aradanmn/MSP430handheld-hardware/pcb/NETLIST.md

# Netlist (generated by pcb/gen_pcb.py -- do not edit)

| Net | Pins |
|-----|---|
| `+3V3` | A1.2, A4.4, C1.1, C13.1, C3.1, C4.1, C5.1, J3.2, R1.1, R10.1, R11.1, R12.1, R2.1, R3.1, R4.1, R5.1, R6.1, R7.1, R8.1, R9.1, U1.1, U2.16, U3.7, U3.8, U4.3, U4.7, U4.8 |
| `+5V` | A3.6, C10.1, C11.1, U5.6 |
| `AMP_BYP` | C8.1, U5.7 |
| `AMP_OUT` | C12.1, C9.1, U5.5 |
| `AUDIO_F` | C6.1, C7.1, R14.2 |
| `AUDIO_IN` | RV1.2, U5.3 |
| `AUDIO_PWM` | R14.1, U1.12 |
| `BTN_A` | R8.2, SW8.1, U2.6 |
| `BTN_B` | R7.2, SW7.1, U2.5 |
| `BTN_DOWN` | R2.2, SW2.1, U2.12 |
| `BTN_LEFT` | R3.2, SW3.1, U2.13 |
| `BTN_RIGHT` | R4.2, SW4.1, U2.14 |
| `BTN_SELECT` | R5.2, SW5.1, U2.3 |
| `BTN_START` | R6.2, SW6.1, U2.4 |
| `BTN_UP` | R1.2, SW1.1, U2.11 |
| `FLASH_CS` | R11.2, U1.19, U4.1 |
| `GND` | A1.1, A1.20, A2.4, A3.2, A3.5, A4.3, C1.2, C10.2, C11.2, C13.2, C14.2, C2.2, C3.2, C4.2, C5.2, C6.2, C8.2, D1.1, J1.2, J2.2, J3.1, R16.2, R19.2, RV1.1, SW1.2, SW2.2, SW3.2, SW4.2, SW5.2, SW6.2, SW7.2, SW8.2, SW9.1, U1.20, U2.10, U2.15, U2.8, U3.4, U4.4, U5.2, U5.4 |
| `LED1` | R17.1, U1.2 |
| `LED1_A` | D1.2, R17.2 |
| `MISO` | R13.2, U1.14, U3.2, U4.2 |
| `MOSI` | A1.8, U1.15, U3.5, U4.5 |
| `OLED_CS` | A1.15, R9.2, U1.8 |
| `OLED_DC` | A1.4, U1.9 |
| `OLED_RST` | A1.16, U1.10 |
| `PWR_EN` | A3.3, A4.1, SW9.2 |
| `RST` | C2.1, J3.5, R12.2, U1.16 |
| `RXD` | J3.3, U1.3 |
| `SCK` | A1.7, U1.7, U2.2, U3.6, U4.6 |
| `SPK+` | J2.1, R15.2 |
| `SPK_C` | C9.2, R15.1 |
| `SRAM_CS` | R10.2, U1.13, U3.1 |
| `SR_LOAD` | U1.11, U2.1 |
| `SR_QH` | R13.1, U2.9 |
| `TEST` | J3.6, U1.17 |
| `TXD` | J3.4, U1.4 |
| `VBAT` | A2.5, A3.1, A4.2, J1.1, R18.1 |
| `VBAT_SENSE` | C14.1, R18.2, R19.1, U1.6 |
| `VOL_HI` | C7.2, RV1.3 |
| `ZOBEL` | C12.2, R16.1 |

| Ref | Value | Side |
|-----|---|---|
| A1 | OLED 128x64 SSD1325 | front |
| A2 | USB-C LiPo charger | back |
| A3 | 5V boost | back |
| A4 | 3.3V buck-boost | front |
| C1 | 100nF | front |
| C2 | 1nF | front |
| C3 | 100nF | front |
| C4 | 100nF | front |
| C5 | 100nF | front |
| C6 | 100nF | front |
| C7 | 10uF | front |
| C8 | 10uF | front |
| C9 | 220uF | front |
| C10 | 100nF | front |
| C11 | 10uF | front |
| C12 | 47nF (opt) | front |
| C13 | 220uF (OLED kit) | front |
| C14 | 100nF | front |
| D1 | red 3mm | front |
| J1 | LiPo (JST-PH) | front |
| J2 | Speaker (solder wires) | back |
| J3 | PROG / UART | back |
| R1 | 10k | front |
| R2 | 10k | front |
| R3 | 10k | front |
| R4 | 10k | front |
| R5 | 10k | front |
| R6 | 10k | front |
| R7 | 10k | front |
| R8 | 10k | front |
| R9 | 10k | front |
| R10 | 10k | front |
| R11 | 10k | front |
| R12 | 47k | front |
| R13 | 1k | front |
| R14 | 1k | front |
| R15 | 10R | front |
| R16 | 10R (opt) | front |
| R17 | 1k | front |
| R18 | 470k | front |
| R19 | 470k | front |
| RV1 | 10k log (PTV09A) | front |
| SW1 | UP | front |
| SW2 | DOWN | front |
| SW3 | LEFT | front |
| SW4 | RIGHT | front |
| SW5 | SELECT | front |
| SW6 | START | front |
| SW7 | B | front |
| SW8 | A | front |
| SW9 | EG1218 power | back |
| U1 | MSP430G2553IN20 | front |
| U2 | SN74HC165N | front |
| U3 | 23LC1024-I/P | front |
| U4 | W25Q128 (Adafruit #5634) | front |
| U5 | LM386N-1 | front |
