aradanmn/MSP430handheld-hardware/enclosure/renders/back_shell.png

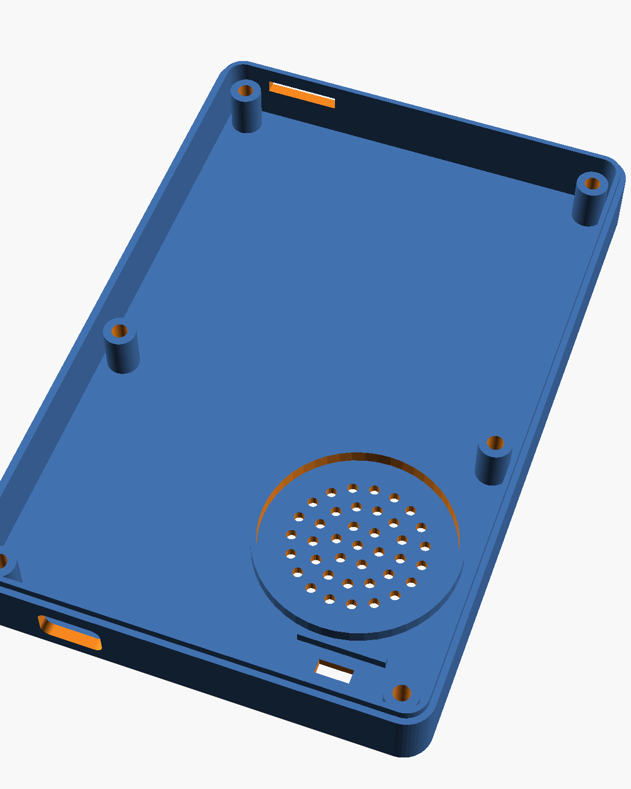
enclosure/renders/back_shell.png
