aradanmn/MSP430handheld-hardware/enclosure/renders/front_shell.png

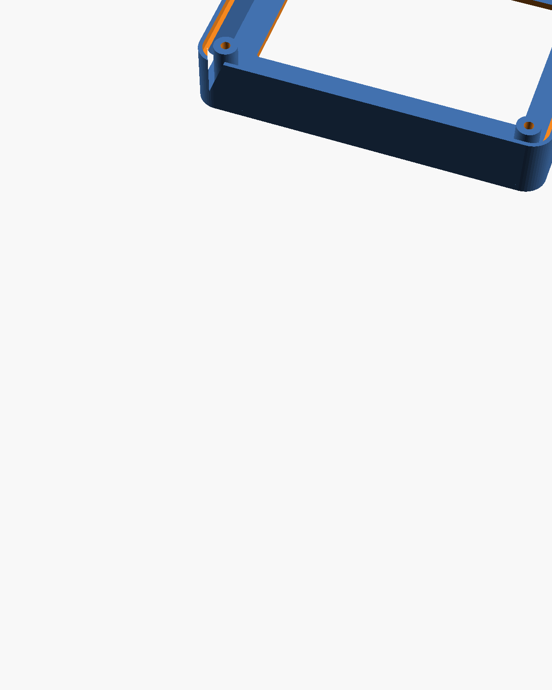
enclosure/renders/front_shell.png
