aradanmn/MSP430handheld-hardware/enclosure/renders/section_x21.png

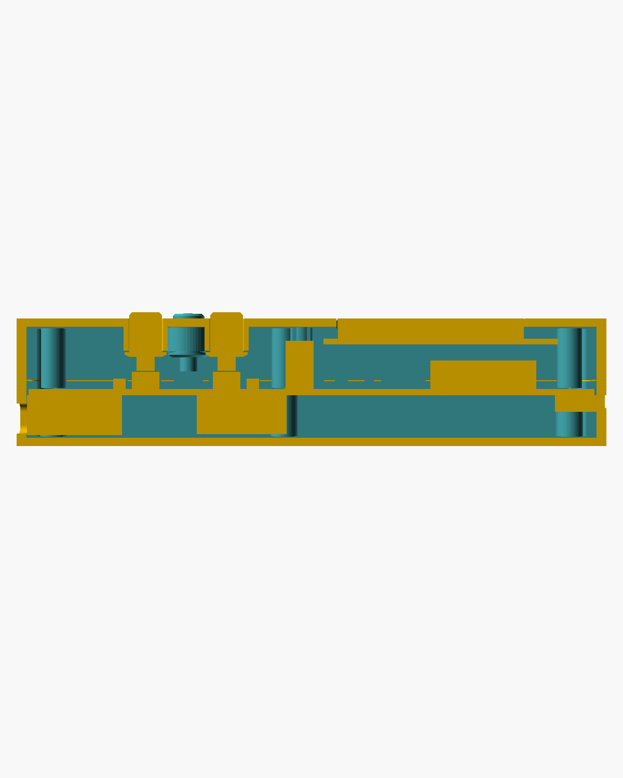
enclosure/renders/section_x21.png
