aradanmn/MSP430handheld-hardware/enclosure/renders/section_x45.png

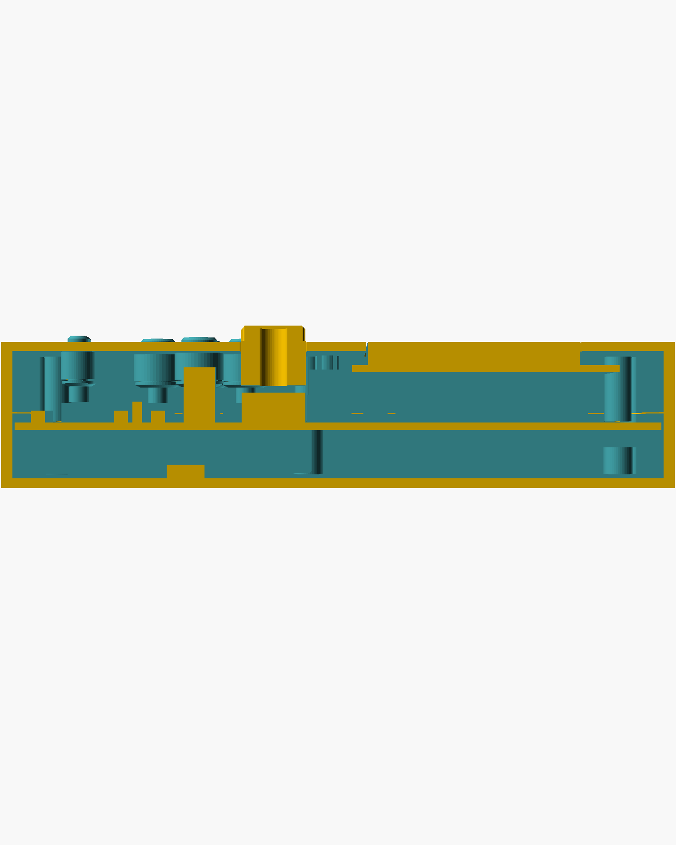
enclosure/renders/section_x45.png
