aradanmn/MSP430handheld-hardware/pcb/renders/bottom.png

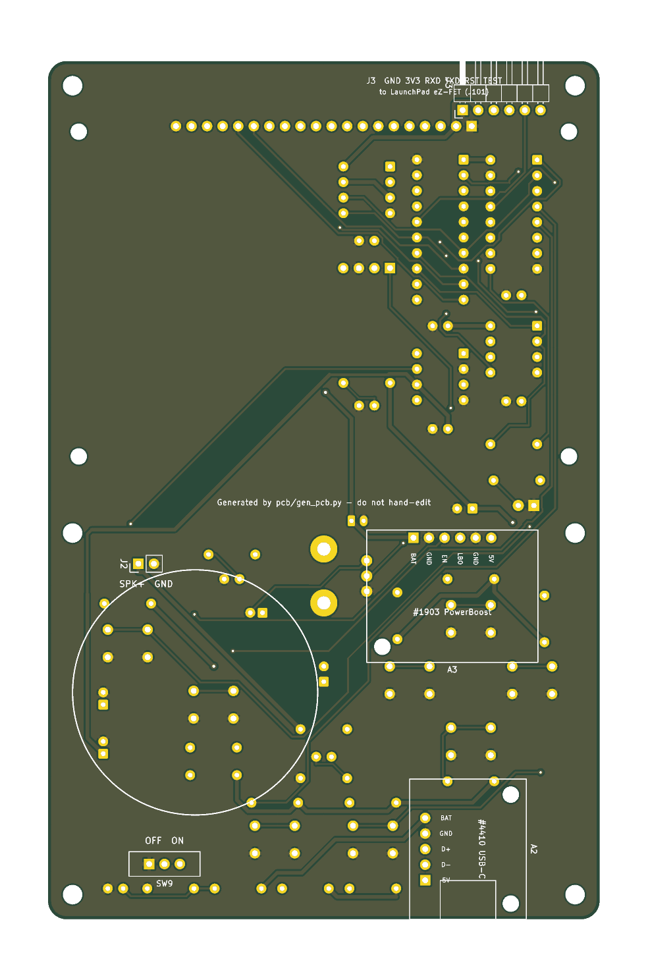
pcb/renders/bottom.png
