aradanmn/MSP430handheld-hardware/enclosure/stl/handheld_cap_dpad.stl

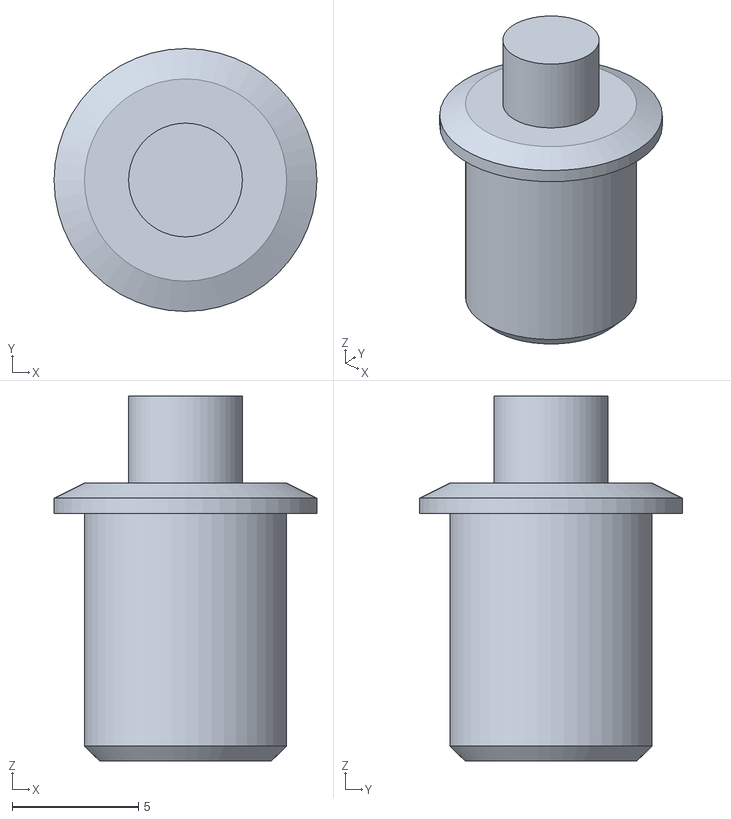
[picture p8: CAD file, 2026-11-09]
enclosure/stl/handheld_cap_dpad.stl
10.4 x 10.4 x 14.4
