aradanmn/MSP430handheld-hardware/pcb/fab/msp430_handheld-outline.dxf

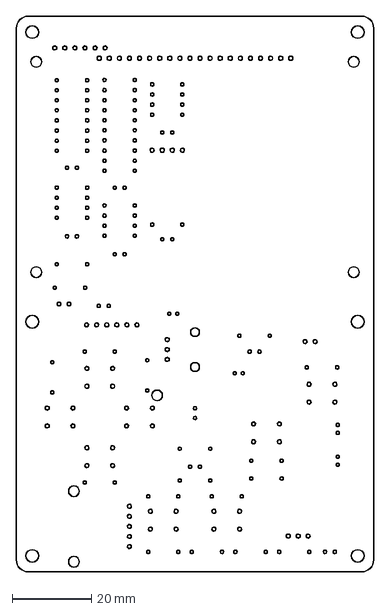
[picture p9: CAD file, 2026-11-09]
pcb/fab/msp430_handheld-outline.dxf
90.0 x 140.0 mm
