aradanmn/MSP430handheld-hardware/enclosure/stl/handheld_knob.stl

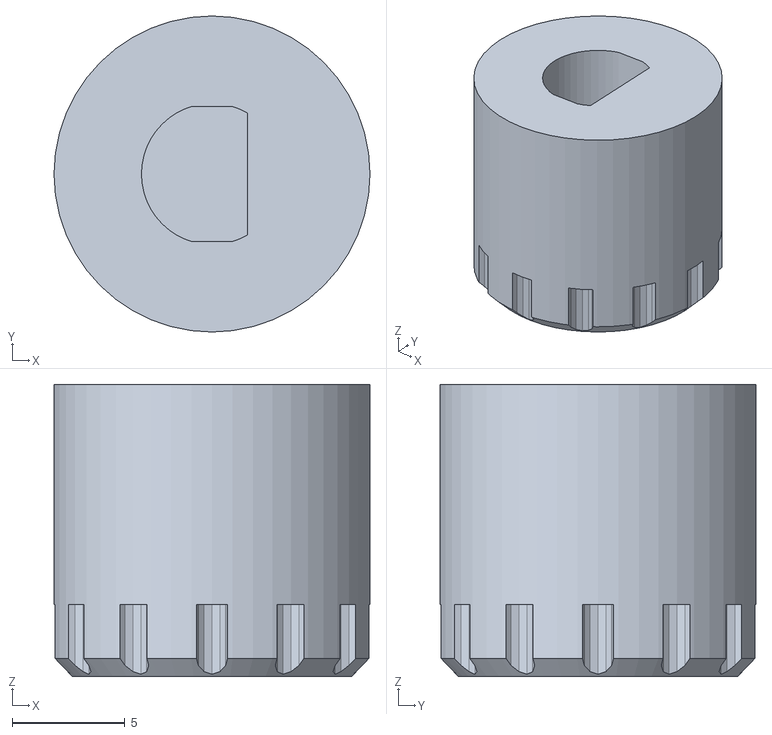
[picture p10: CAD file, 2026-11-09]
enclosure/stl/handheld_knob.stl
14.0 x 14.0 x 12.9
