aradanmn/MSP430handheld-hardware/pcb/fab/msp430_handheld.step

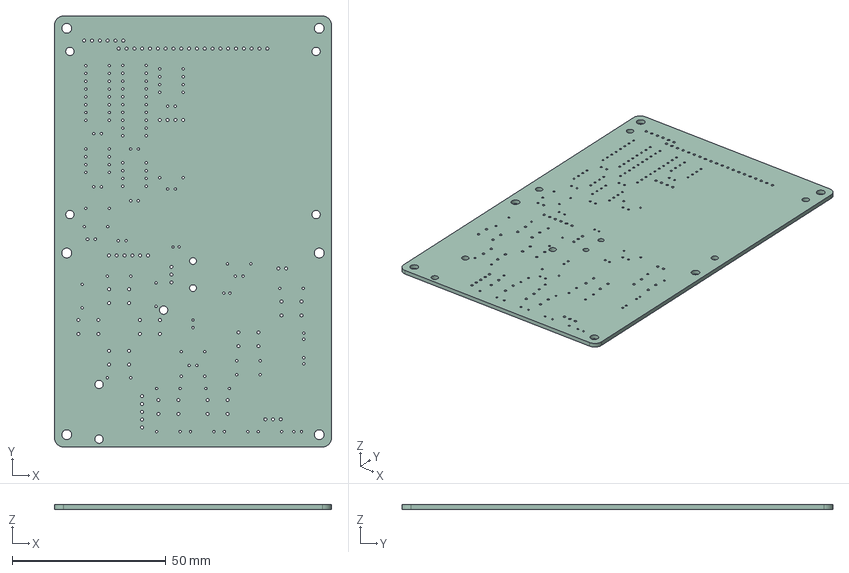
[picture p11: CAD file, 2026-11-09]
pcb/fab/msp430_handheld.step
90.0 x 140.0 x 1.51 mm
