aradanmn/MSP430handheld-hardware/enclosure/stl/handheld_slider.stl

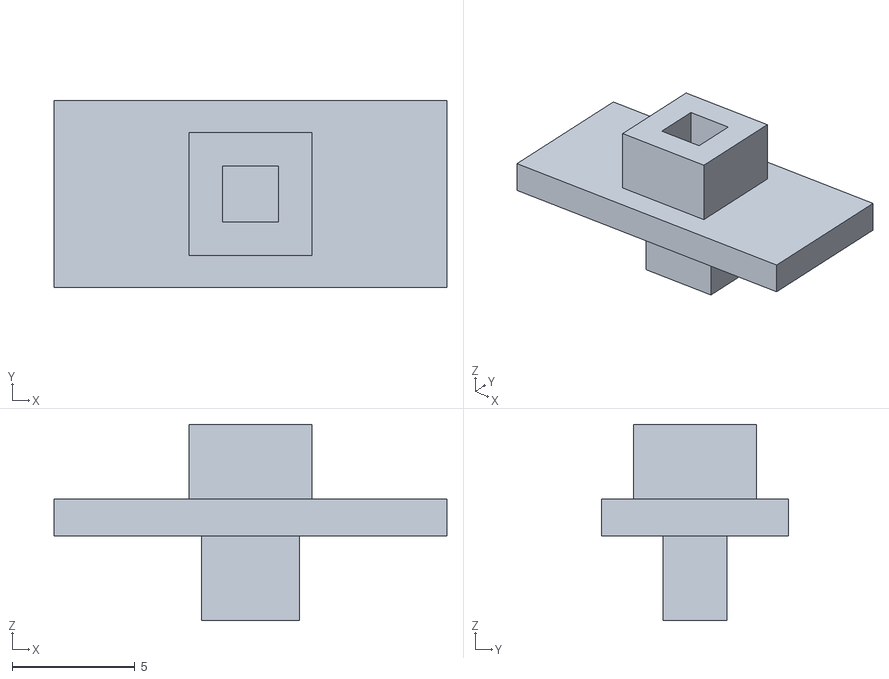
[picture p12: CAD file, 2026-11-09]
enclosure/stl/handheld_slider.stl
16.0 x 7.60 x 8.00
