aradanmn/MSP430handheld-hardware/enclosure/stl/handheld_cap_pill.stl

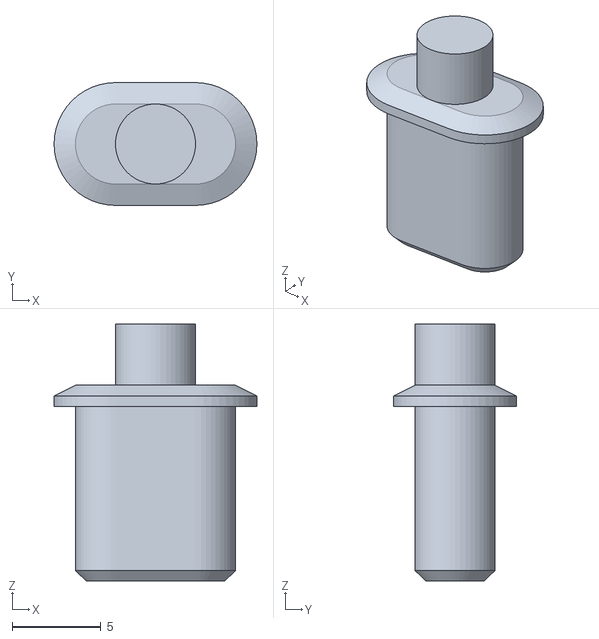
[picture p13: CAD file, 2026-11-09]
enclosure/stl/handheld_cap_pill.stl
11.4 x 6.90 x 14.4
