aradanmn/MSP430handheld-hardware/enclosure/stl/handheld_back.stl

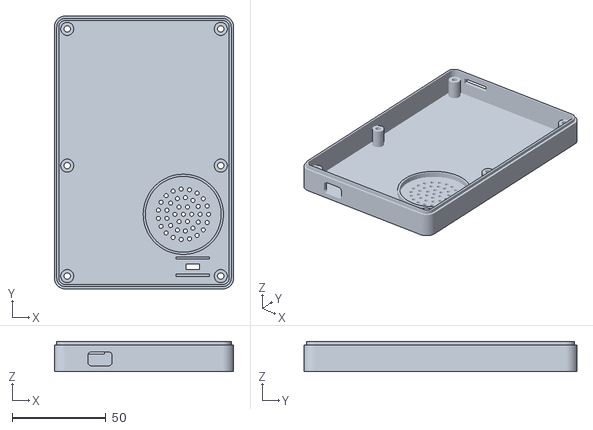
[picture p14: CAD file, 2026-11-09]
enclosure/stl/handheld_back.stl
95.8 x 145.8 x 16.1
