aradanmn/MSP430handheld-hardware/enclosure/stl/handheld_front.stl

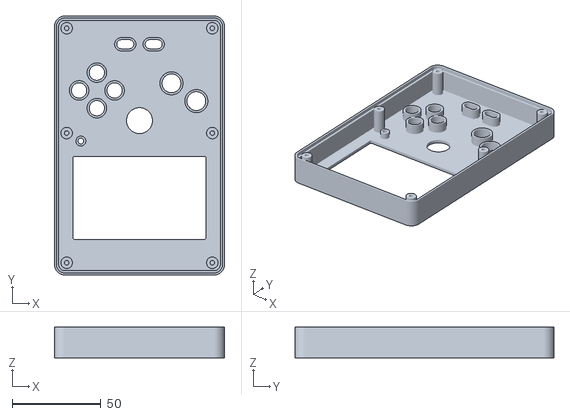
[picture p15: CAD file, 2026-11-09]
enclosure/stl/handheld_front.stl
95.8 x 145.8 x 17.4
