aradanmn/MSP430handheld-hardware/enclosure/stl/handheld_cap_ab.stl

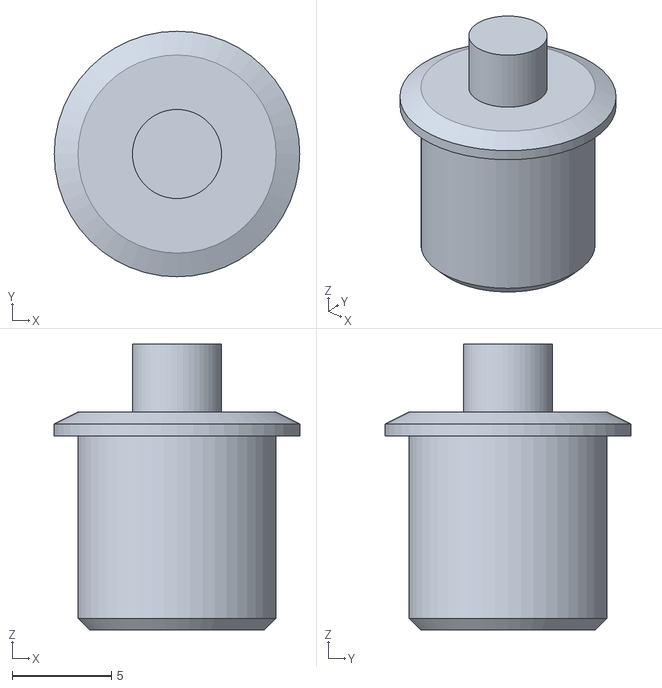
[picture p16: CAD file, 2026-11-09]
enclosure/stl/handheld_cap_ab.stl
12.4 x 12.4 x 14.4
