aradanmn/MSP430handheld-hardware/enclosure/board_params.scad

// GENERATED by pcb/gen_pcb.py from pcb/handheld_design.py -- do not edit.
// Board FRONT-view coordinates: origin top-left of the PCB, x right, y down, mm.
pcb_w = 90.0; pcb_h = 140.0; pcb_r = 3.0; pcb_t = 1.6;
case_screws = [[4, 4], [86, 4], [4, 77], [86, 77], [4, 136], [86, 136]];
oled_at = [2.5, 9.0]; oled_size = [85.0, 58.0]; oled_gap = 11.04;
oled_pcb_t = 1.4; oled_bezel = [5.5, 8.5, 74.0, 46.0]; oled_bezel_h = 5.0;
oled_holes = [[2.5, 2.5], [82.5, 2.5], [2.5, 55.5], [82.5, 55.5]];
buttons = [["UP", 21, 91, "dpad"], ["DOWN", 21, 111, "dpad"], ["LEFT", 11, 101, "dpad"], ["RIGHT", 31, 101, "dpad"], ["SELECT", 37, 127, "pill"], ["START", 53, 127, "pill"], ["B", 63, 105, "ab"], ["A", 77, 95, "ab"]];
volume_at = [45.0, 84.0]; led_at = [12.0, 72.5]; pwr_switch_at = [71.0, 131.0];
battery = [45.0, 12.5, 36.0, 60.0, 7.0];
speaker = [66.0, 103.0, 40.0, 6.5];
usb_c_x = 21.475;   // charger USB-C centre, bottom edge
prog_at = [16.0, 8.0]; prog_n = 6;   // J3, pins leave through the top wall
// [ref, side, x0, y0, x1, y1, height] courtyard boxes for the fit model
parts = [
  ["U1", "F", 20.62, 14.45, 31.38, 40.55, 7.0],
  ["C1", "F", 23.66, 42.1, 28.34, 44.3, 4.5],
  ["R12", "F", 33.09, 50.95, 42.91, 54.05, 2.6],
  ["C2", "F", 35.66, 55.1, 40.34, 57.3, 4.5],
  ["J3", "B", 7.83, -2.58, 24.16, 9.81, 4.0],
  ["U2", "F", 9.09, 14.54, 18.91, 35.45, 4.6],
  ["U3", "F", 9.09, 41.62, 18.91, 52.38, 4.6],
  ["U4", "F", 33.09, 15.62, 42.91, 26.38, 4.6],
  ["U5", "F", 21.09, 46.12, 30.91, 56.88, 4.6],
  ["C3", "F", 11.65, 37.1, 16.34, 39.3, 4.5],
  ["C4", "F", 11.65, 54.41, 16.34, 56.59, 4.5],
  ["C5", "F", 35.66, 28.2, 40.34, 30.39, 4.5],
  ["C10", "F", 23.66, 58.91, 28.34, 61.09, 4.5],
  ["A4", "F", 32.0, 32.2, 44.02, 49.3, 5.6],
  ["A2", "B", 11.65, 116.84, 31.3, 140.29, 9.8],
  ["A3", "B", 9.77, 76.2, 38.3, 98.39, 9.6],
  ["J1", "F", 36.01, 68.2, 42.99, 76.89, 6.0],
  ["SW9", "B", 64.91, 128.71, 77.09, 133.29, 7.4],
  ["R18", "F", 54.09, 133.46, 63.91, 136.54, 2.6],
  ["R19", "F", 65.09, 133.46, 74.91, 136.54, 2.6],
  ["C14", "F", 76.66, 133.91, 81.34, 136.09, 4.5],
  ["C13", "F", 18.56, 69.55, 25.44, 76.45, 12.0],
  ["SW1", "F", 16.61, 87.61, 25.39, 94.39, 4.3],
  ["SW2", "F", 16.61, 107.61, 25.39, 114.39, 4.3],
  ["SW3", "F", 6.61, 97.61, 15.39, 104.39, 4.3],
  ["SW4", "F", 26.61, 97.61, 35.4, 104.39, 4.3],
  ["SW5", "F", 32.6, 123.61, 41.4, 130.4, 4.3],
  ["SW6", "F", 48.6, 123.61, 57.4, 130.4, 4.3],
  ["SW7", "F", 58.6, 101.61, 67.39, 108.39, 4.3],
  ["SW8", "F", 72.61, 91.61, 81.39, 98.39, 4.3],
  ["R1", "F", 16.09, 82.95, 25.91, 86.05, 2.6],
  ["R2", "F", 16.09, 115.95, 25.91, 119.05, 2.6],
  ["R3", "F", 7.46, 86.09, 10.54, 95.91, 2.6],
  ["R4", "F", 31.45, 85.59, 34.55, 95.41, 2.6],
  ["R5", "F", 32.09, 119.45, 41.9, 122.55, 2.6],
  ["R6", "F", 48.09, 119.45, 57.91, 122.55, 2.6],
  ["R7", "F", 58.09, 110.45, 67.91, 113.55, 2.6],
  ["R8", "F", 72.09, 86.95, 81.91, 90.05, 2.6],
  ["R9", "F", 32.09, 133.46, 41.9, 136.54, 2.6],
  ["R10", "F", 43.09, 133.46, 52.91, 136.54, 2.6],
  ["R11", "F", 58.09, 114.95, 67.91, 118.05, 2.6],
  ["R13", "F", 9.1, 60.95, 18.91, 64.05, 2.6],
  ["D1", "F", 9.54, 70.25, 14.46, 74.75, 17.0],
  ["R17", "F", 8.6, 66.86, 18.41, 69.94, 2.6],
  ["R14", "F", 55.09, 78.95, 64.91, 82.05, 2.6],
  ["C6", "F", 57.66, 83.41, 62.34, 85.59, 4.5],
  ["C7", "F", 53.21, 87.21, 58.79, 92.79, 12.0],
  ["RV1", "F", 36.8, 77.09, 51.3, 90.91, 6.5],
  ["C8", "F", 78.21, 101.21, 83.79, 106.79, 12.0],
  ["C11", "F", 78.21, 109.21, 83.79, 114.79, 12.0],
  ["C9", "F", 41.56, 96.55, 48.44, 103.45, 12.0],
  ["R15", "F", 40.09, 107.45, 49.91, 110.55, 2.6],
  ["C12", "F", 42.66, 112.41, 47.34, 114.59, 4.5],
  ["R16", "F", 40.09, 115.45, 49.91, 118.55, 2.6],
  ["J2", "B", 70.91, 80.19, 77.08, 83.81, 2.0],
];
