aradanmn/MSP430handheld-hardware/enclosure/renders/assembly_back.png

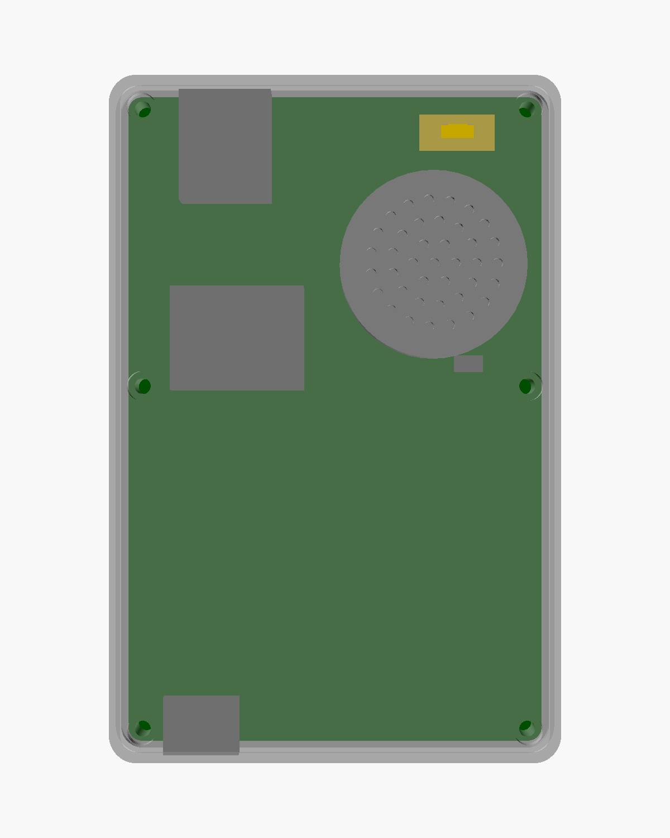
enclosure/renders/assembly_back.png
