aradanmn/MSP430handheld-hardware/schematic/msp430_handheld.pdf

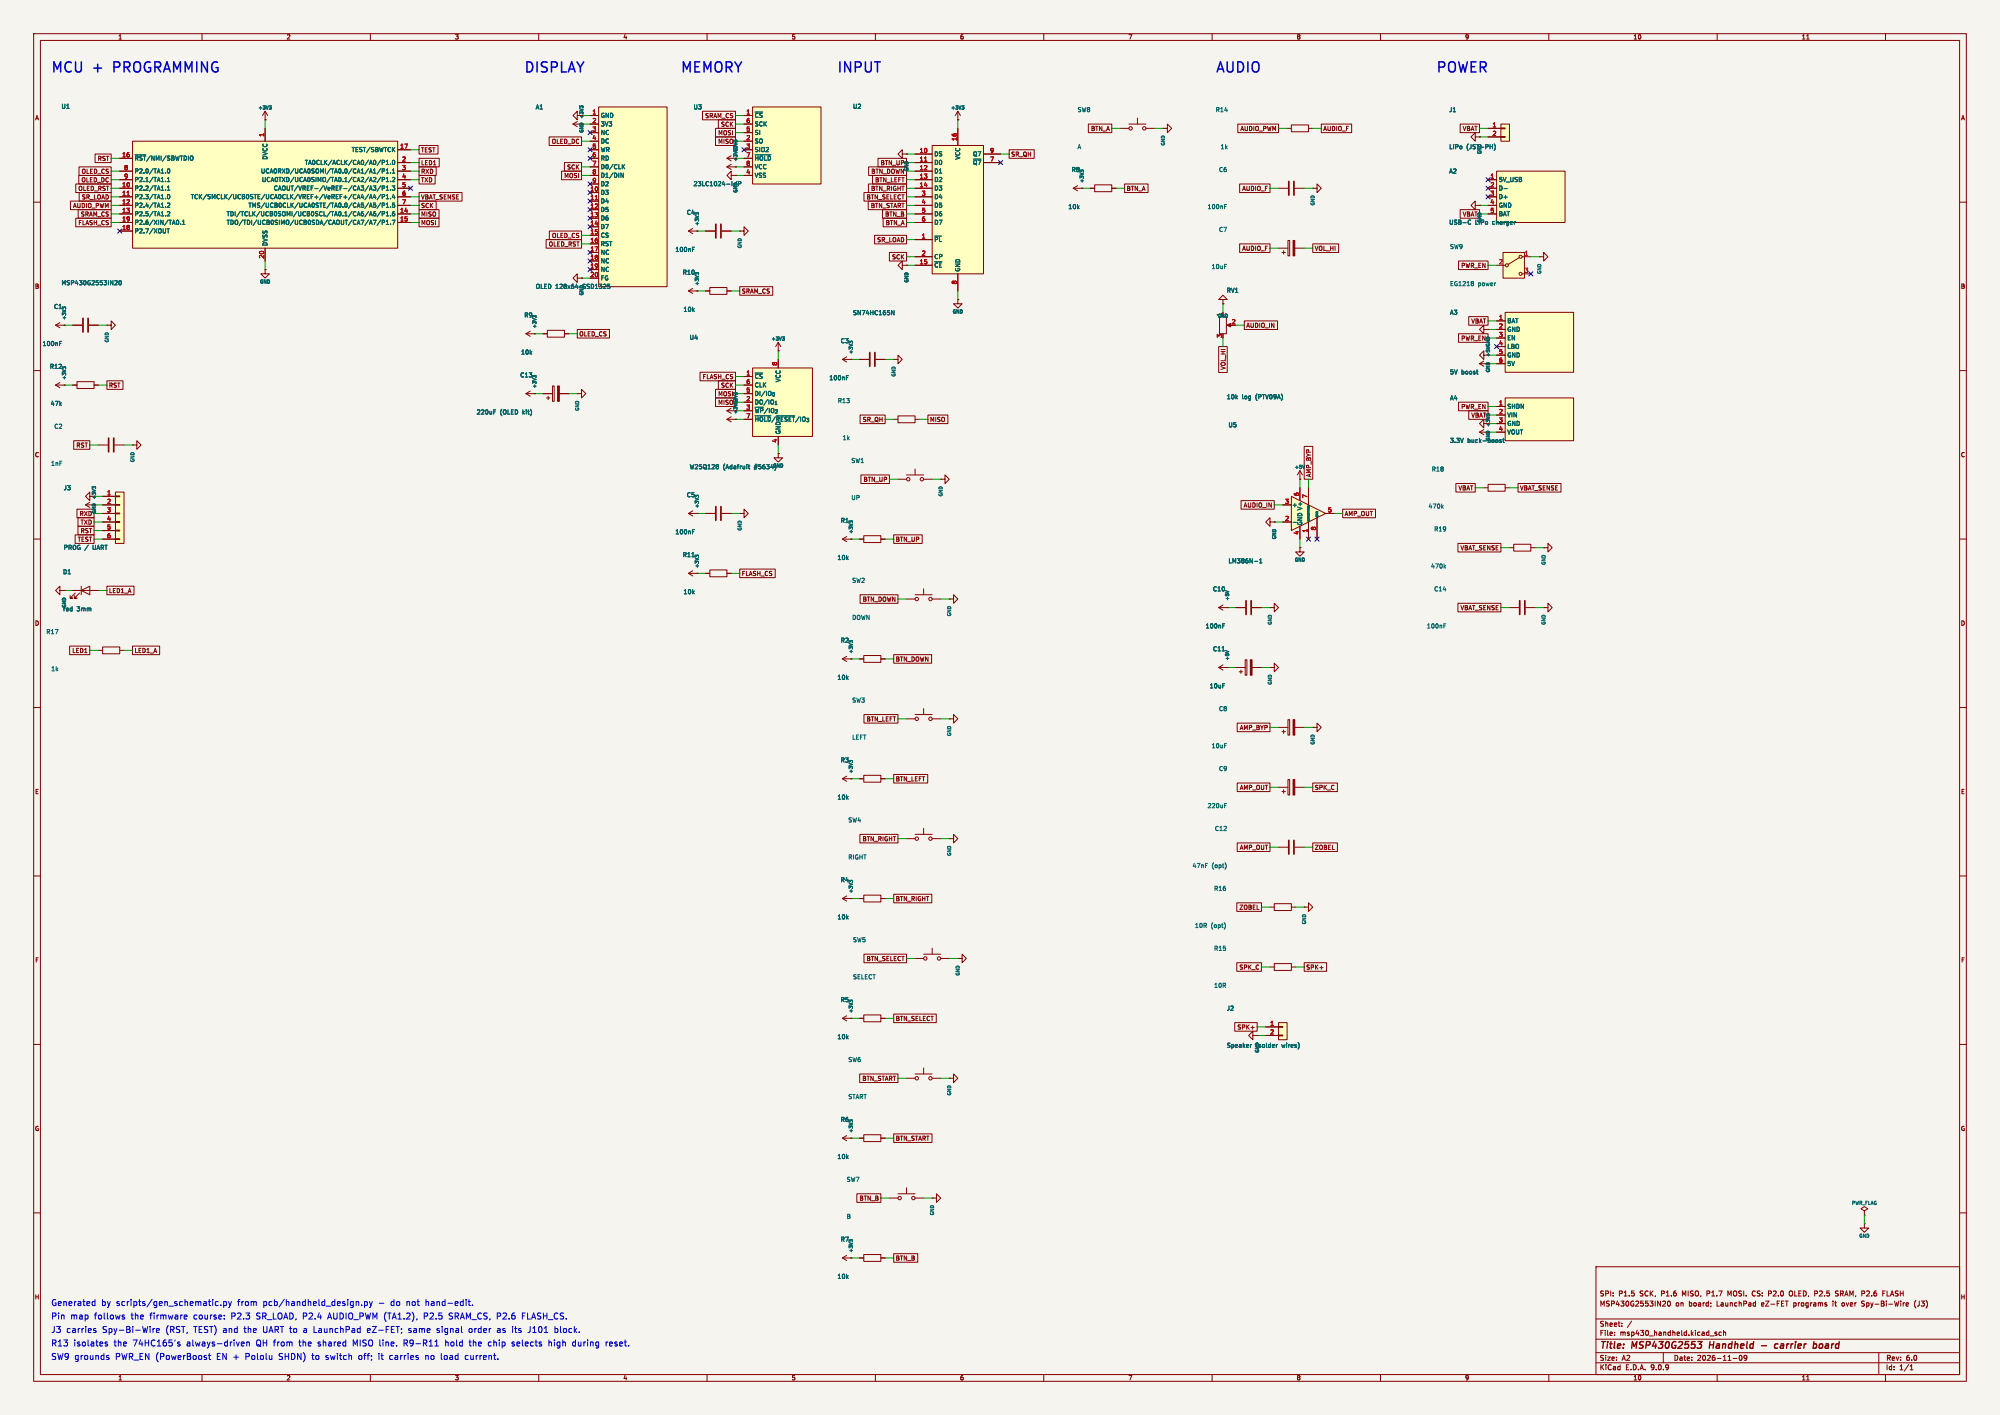
[picture p18: page 1]

1 DVSS 20 TEST/SBWTCK 17 TA0CLK/ACLK/CA0/A0/P1.0 2 UCA0RXD/UCA0SOMI/TA0.0/CA1/A1/P1.1 3 UCA0TXD/UCA0SIMO/TA0.1/CA2/A2/P1.2 4 CAOUT/VREF-/VeREF-/CA3/A3/P1.3 5 TCK/SMCLK/UCB0STE/UCA0CLK/VREF+/VeREF+/CA4/A4/P1.4 6 TMS/UCB0CLK/UCA0STE/TA0.0/CA5/A5/P1.5 7 TDI/TCLK/UCB0SOMI/UCB0SCL/TA0.1/CA6/A6/P1.6 14 TDO/TDI/UCB0SIMO/UCB0SDA/CAOUT/CA7/A7/P1.7 15 U1 MSP430G2553IN20 C6
3V3 2 NC 3 DC 4 WR 5 RD 6 D0/CLK 7 D1/DIN 8 D2 9 D3 10 D4 11 D5 12 D6 13 D7 14 CS 15 RST 16 NC 17 NC 18 NC 19 FG 20 A1OLED 128x64 SSD1325 R17

10k log (PTV09A) GND GND SW4 RIGHT +3V3 GND

~{CS} 1 SCK 6 SI 5 SO 2 SIO2 3 ~{HOLD} 7 VCC 8 VSS 4 U3
SRAM_CS
SCK
VBAT BTN_B MISO

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
