aradanmn/MSP430handheld-hardware/pcb/msp430_handheld.kicad_pcb

## KiCad design pcb/msp430_handheld.kicad_pcb (2026-11-09)

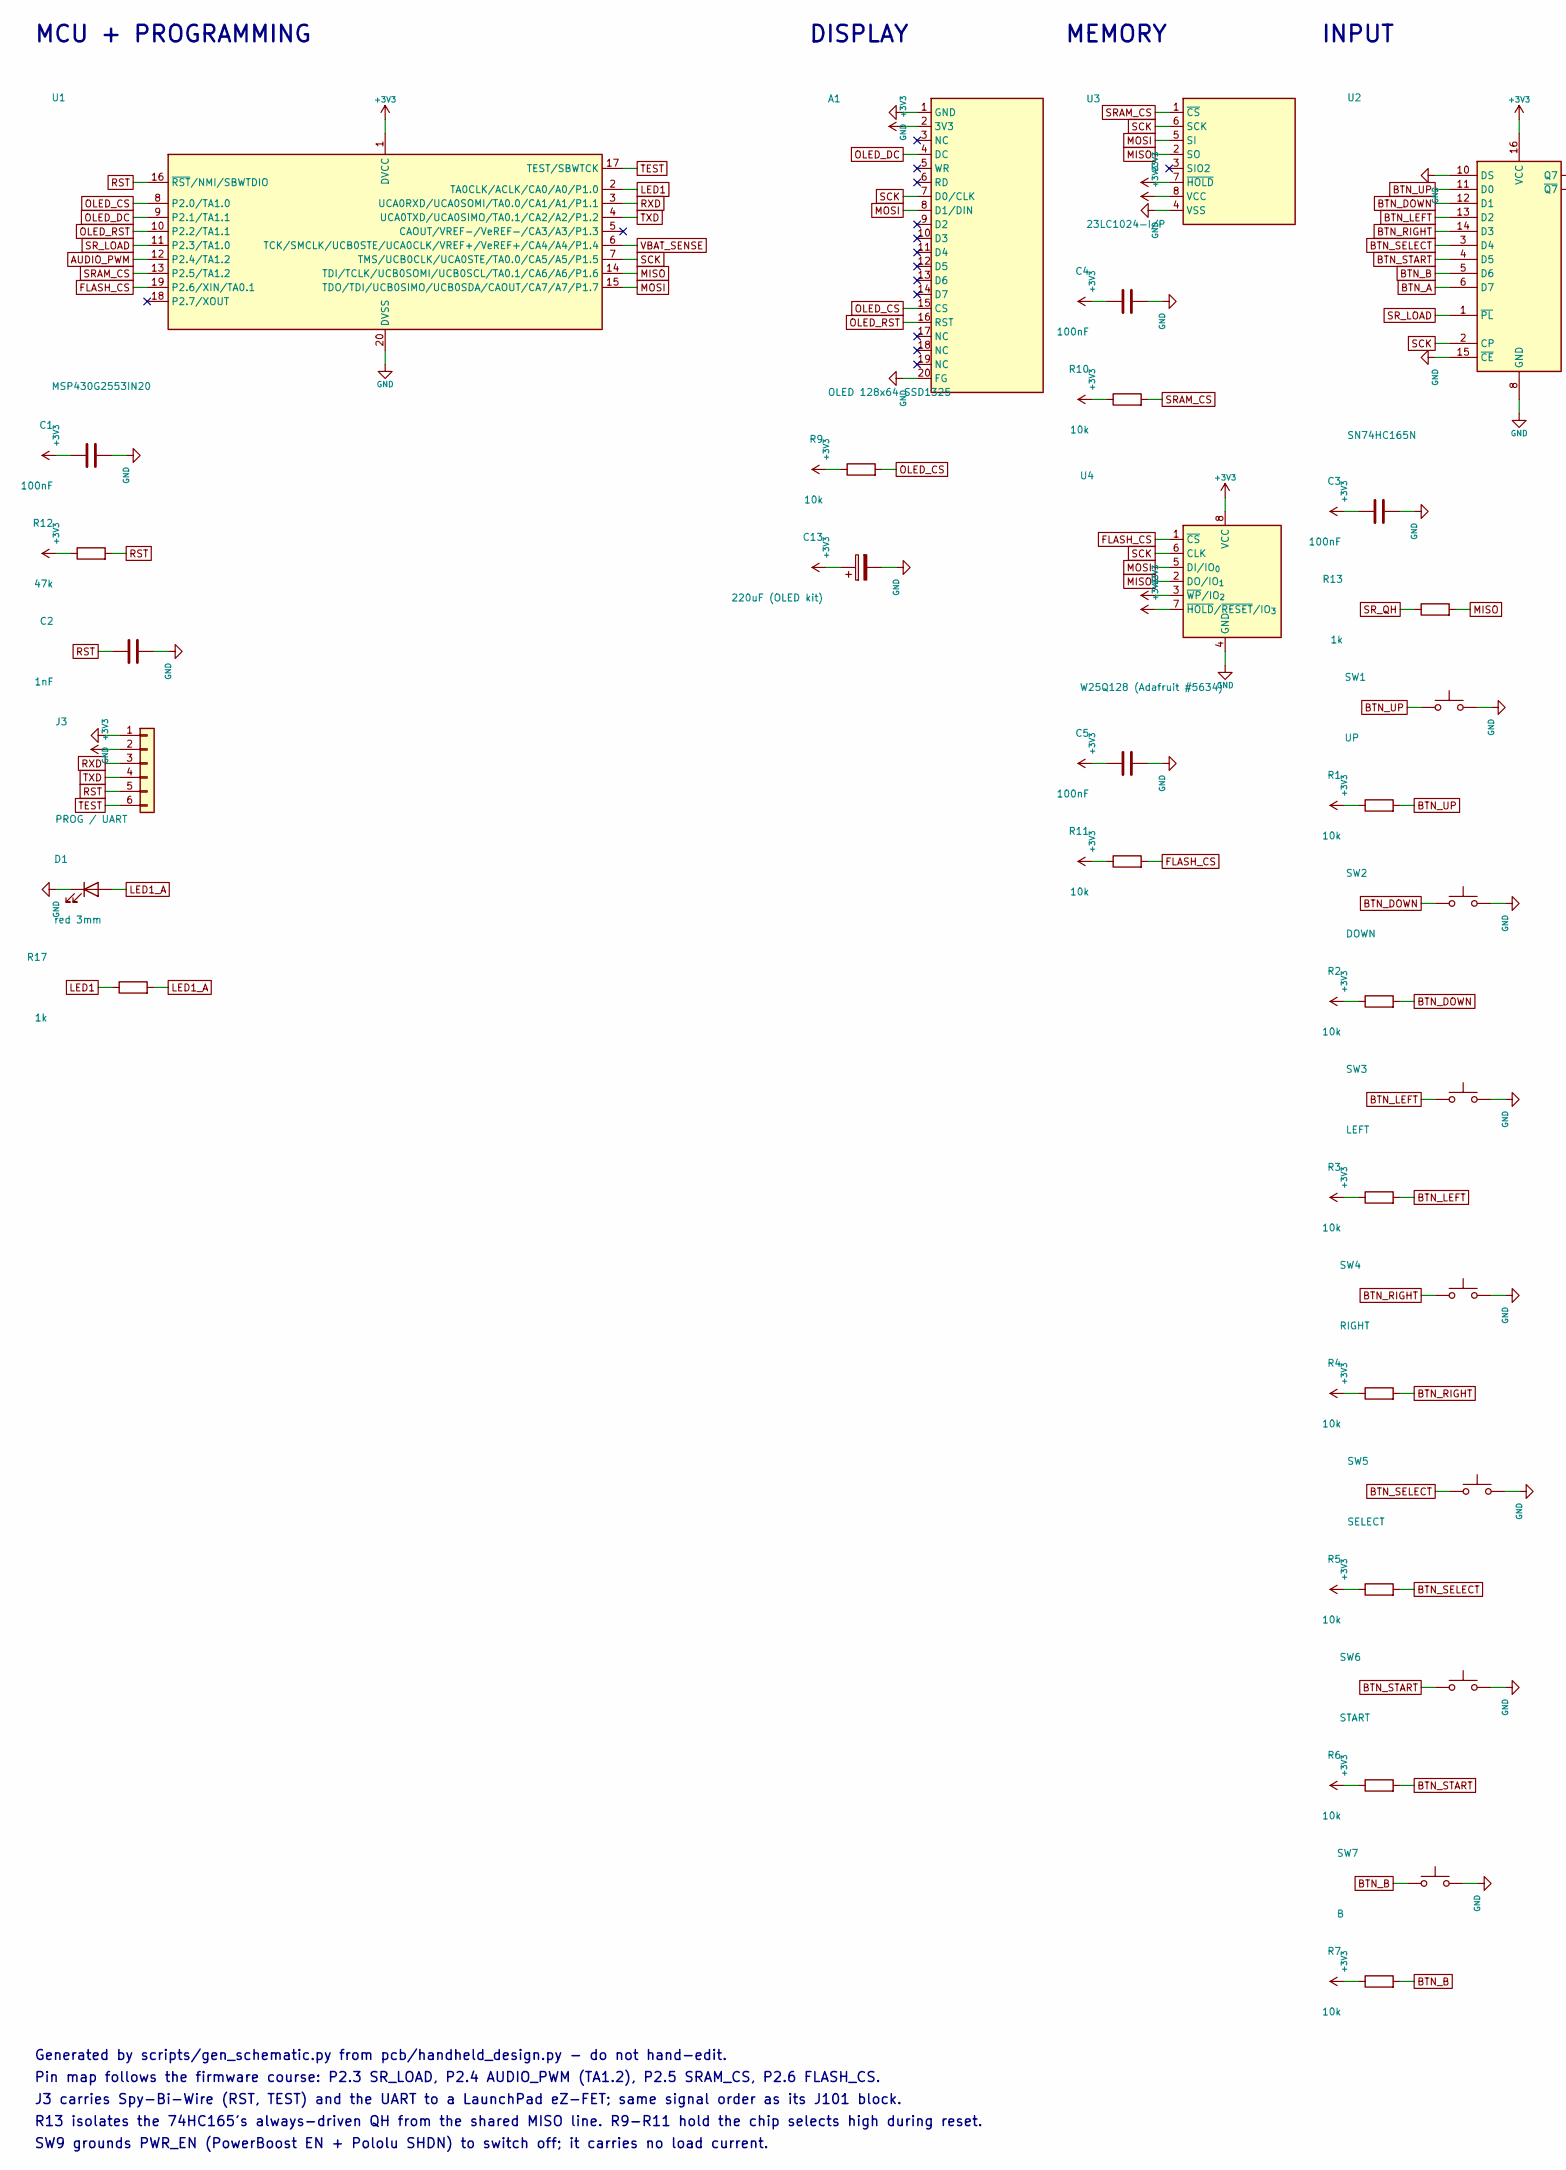
[picture p19: schematic msp430_handheld.kicad_sch, MSP430G2553 Handheld - carrier board, part in row 1, column 1]

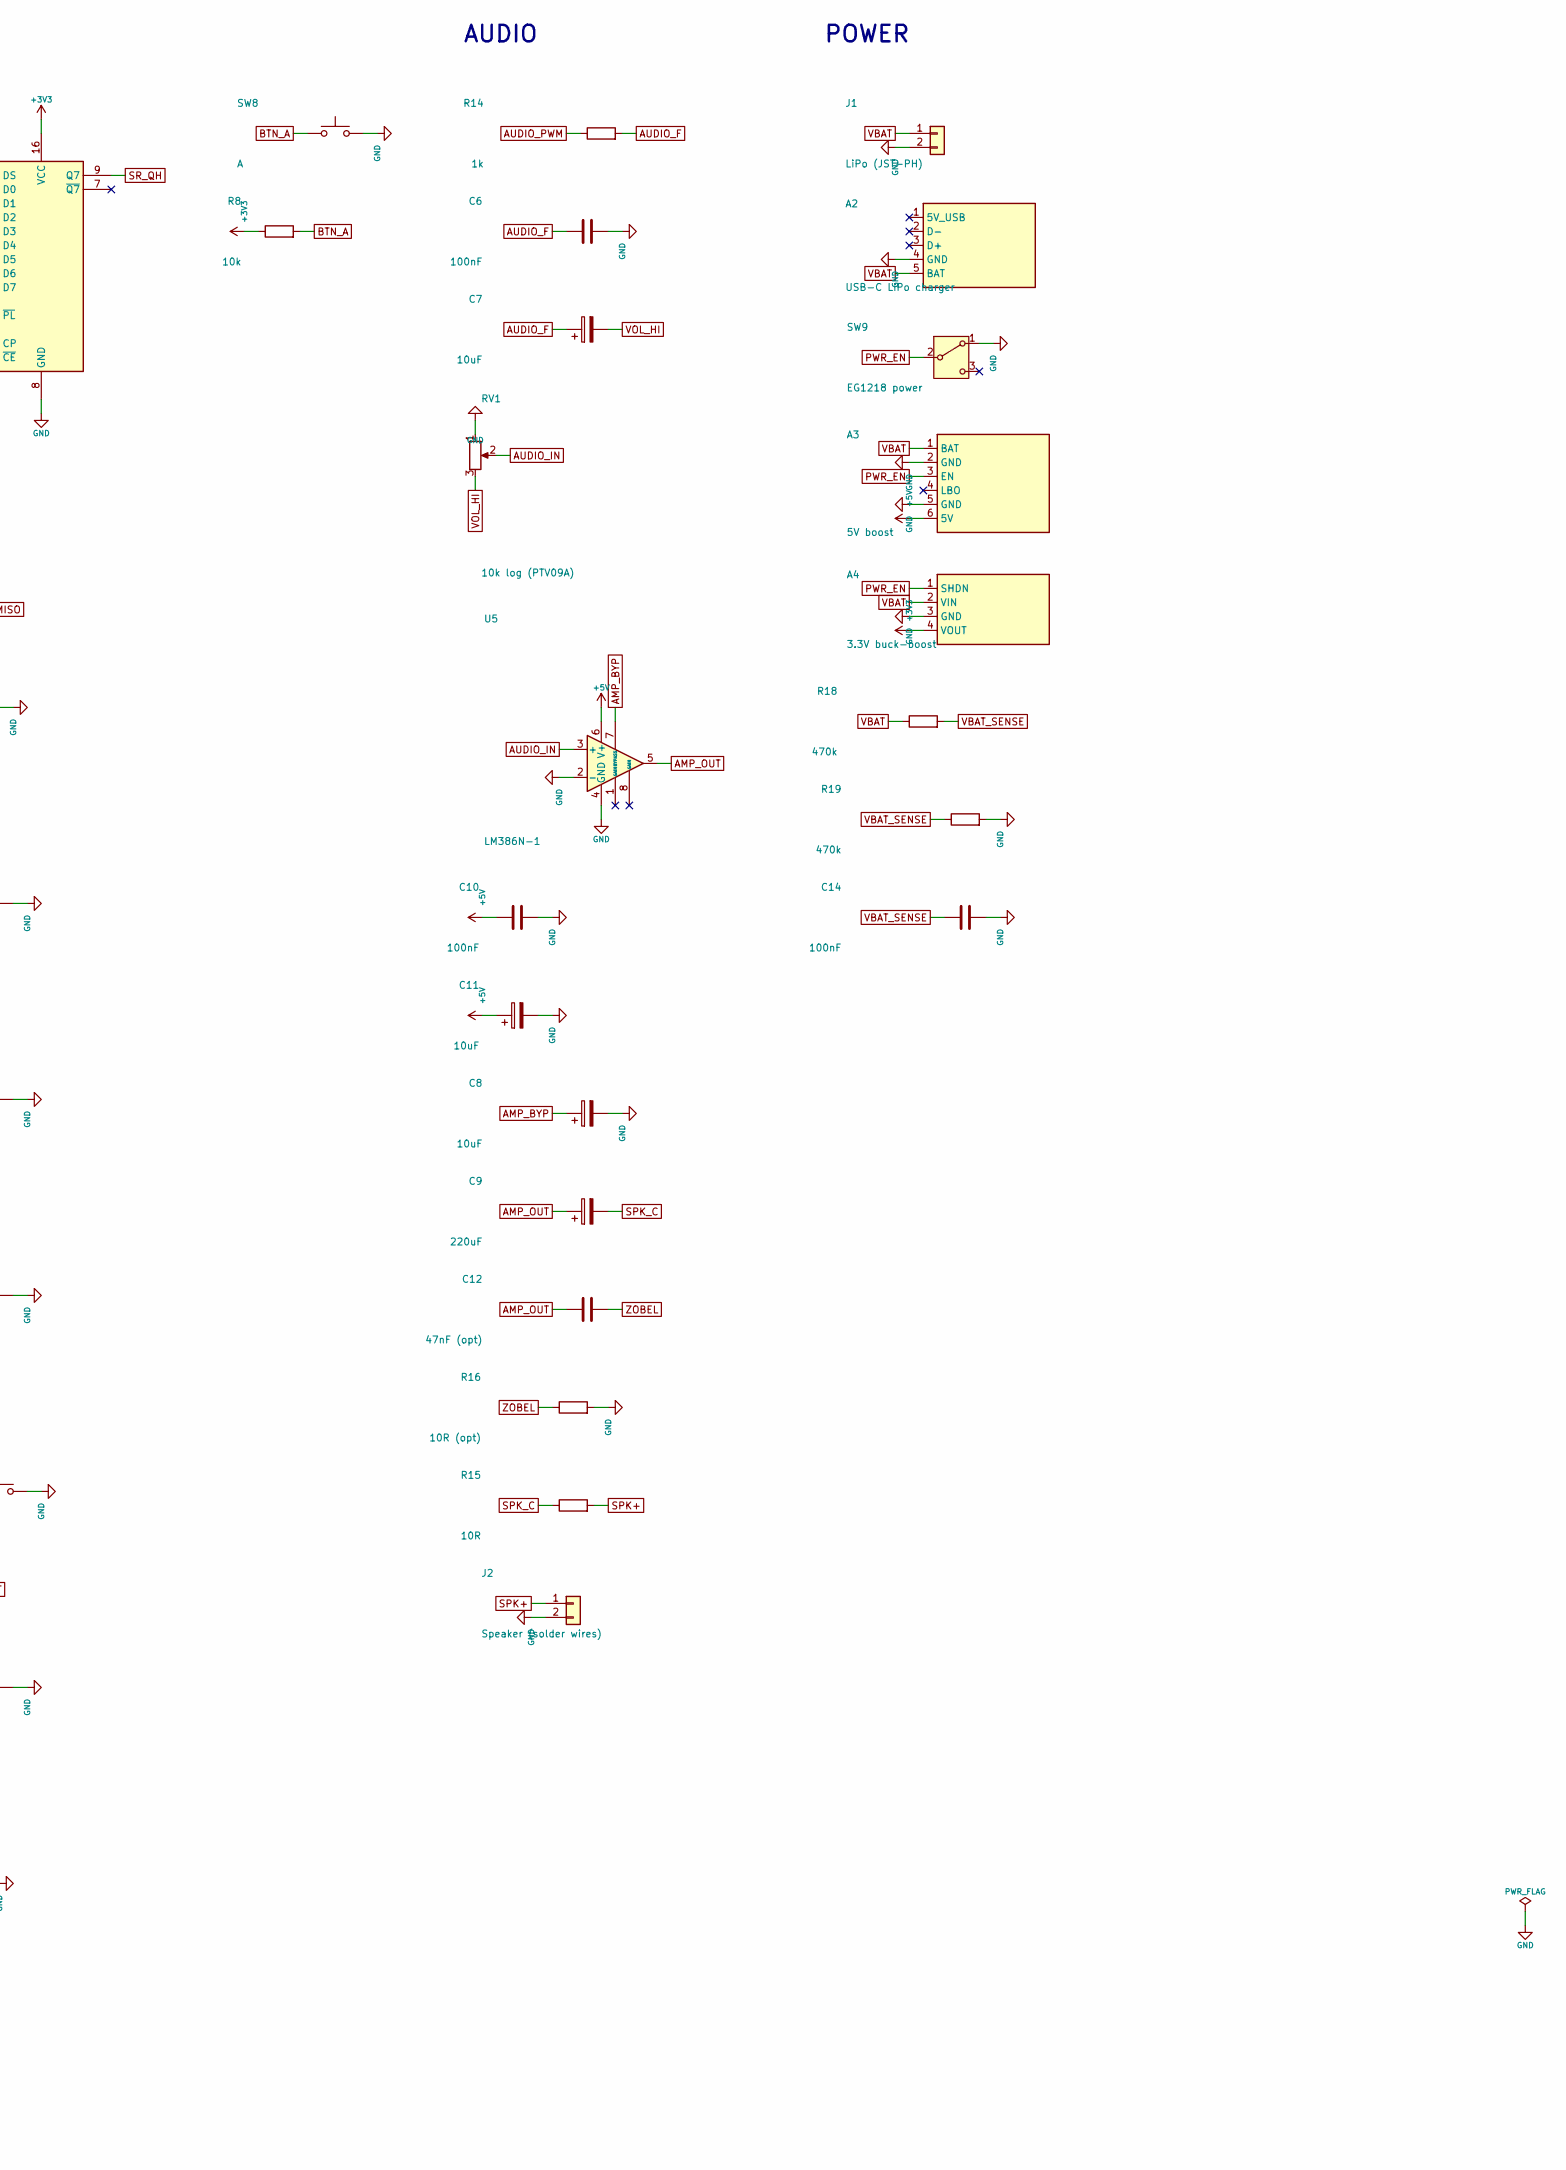
[picture p20: schematic msp430_handheld.kicad_sch, MSP430G2553 Handheld - carrier board, part in row 1, column 2]

Parts:
A1: OLED 128x64 SSD1325; Adafruit_2674_OLED_2.7in
A2: USB-C LiPo charger; Adafruit_4410_USBC_LiPo
A3: 5V boost; Adafruit_1903_PowerBoost500
A4: 3.3V buck-boost; Pololu_S7V8F3
C1, C3, C4, C5, C6, C10, C14: 100nF; C_Disc_D3.0mm_W1.6mm_P2.50mm
C2: 1nF; C_Disc_D3.0mm_W1.6mm_P2.50mm
C7, C8, C11: 10uF; CP_Radial_D5.0mm_P2.00mm
C9: 220uF; CP_Radial_D6.3mm_P2.50mm
C12: 47nF (opt); C_Disc_D3.0mm_W1.6mm_P2.50mm
C13: 220uF (OLED kit); CP_Radial_D6.3mm_P2.50mm
D1: red 3mm; LED_D3.0mm
J1: LiPo (JST-PH); JST_PH_S2B-PH-K_1x02_P2.00mm_Horizontal
J2: Speaker (solder wires); PinHeader_1x02_P2.54mm_Vertical
J3: PROG / UART; PinHeader_1x06_P2.54mm_Horizontal
R1, R2, R3, R4, R5, R6, R7, R8, R9, R10, R11: 10k; R_Axial_DIN0207_L6.3mm_D2.5mm_P7.62mm_Horizontal
R12: 47k; R_Axial_DIN0207_L6.3mm_D2.5mm_P7.62mm_Horizontal
R13, R14, R17: 1k; R_Axial_DIN0207_L6.3mm_D2.5mm_P7.62mm_Horizontal
R15: 10R; R_Axial_DIN0207_L6.3mm_D2.5mm_P7.62mm_Horizontal
R16: 10R (opt); R_Axial_DIN0207_L6.3mm_D2.5mm_P7.62mm_Horizontal
R18, R19: 470k; R_Axial_DIN0207_L6.3mm_D2.5mm_P7.62mm_Horizontal
RV1: 10k log (PTV09A); Potentiometer_Bourns_PTV09A-1_Single_Vertical
SW1: UP; SW_TH_Tactile_Omron_B3F-100x
SW2: DOWN; SW_TH_Tactile_Omron_B3F-100x
SW3: LEFT; SW_TH_Tactile_Omron_B3F-100x
SW4: RIGHT; SW_TH_Tactile_Omron_B3F-100x
SW5: SELECT; SW_TH_Tactile_Omron_B3F-100x
SW6: START; SW_TH_Tactile_Omron_B3F-100x
SW7: B; SW_TH_Tactile_Omron_B3F-100x
SW8: A; SW_TH_Tactile_Omron_B3F-100x
SW9: EG1218 power; SW_E-Switch_EG1218
U1: MSP430G2553IN20; DIP-20_W7.62mm_Socket
U2: SN74HC165N; DIP-16_W7.62mm
U3: 23LC1024-I/P; DIP-8_W7.62mm
U4: W25Q128 (Adafruit #5634); DIP-8_W7.62mm
U5: LM386N-1; DIP-8_W7.62mm

Connections:
+3V3: A1.2 (3V3), A4.4 (VOUT), C1.1, C3.1, C4.1, C5.1, C13.1, J3.2, R1.1, R2.1, R3.1, R4.1, R5.1, R6.1, R7.1, R8.1, R9.1, R10.1, R11.1, R12.1, U1.1 (DVCC), U2.16 (VCC), U3.7 (~HOLD), U3.8 (VCC), U4.3 (~WP/IO_{2}), U4.7 (~HOLD/~RESET/IO_{3}), U4.8 (VCC)
+5V: A3.6 (5V), C10.1, C11.1, U5.6 (V+)
AMP_BYP: C8.1, U5.7 (BYPASS)
AMP_OUT: C9.1, C12.1, U5.5
AUDIO_F: C6.1, C7.1, R14.2
AUDIO_IN: RV1.2, U5.3 (+)
AUDIO_PWM: R14.1, U1.12 (P2.4/TA1.2)
BTN_A: R8.2, SW8.1, U2.6 (D7)
BTN_B: R7.2, SW7.1, U2.5 (D6)
BTN_DOWN: R2.2, SW2.1, U2.12 (D1)
BTN_LEFT: R3.2, SW3.1, U2.13 (D2)
BTN_RIGHT: R4.2, SW4.1, U2.14 (D3)
BTN_SELECT: R5.2, SW5.1, U2.3 (D4)
BTN_START: R6.2, SW6.1, U2.4 (D5)
BTN_UP: R1.2, SW1.1, U2.11 (D0)
FLASH_CS: R11.2, U1.19 (P2.6/XIN/TA0.1), U4.1 (~CS)
GND: A1.1 (GND), A1.20 (FG), A2.4 (GND), A3.2 (GND), A3.5 (GND), A4.3 (GND), C1.2, C2.2, C3.2, C4.2, C5.2, C6.2, C8.2, C10.2, C11.2, C13.2, C14.2, D1.1 (K), J1.2, J2.2, J3.1, R16.2, R19.2, RV1.1, SW1.2, SW2.2, SW3.2, SW4.2, SW5.2, SW6.2, SW7.2, SW8.2, SW9.1 (A), U1.20 (DVSS), U2.8 (GND), U2.10 (DS), U2.15 (~CE), U3.4 (VSS), U4.4 (GND), U5.2 (-), U5.4 (GND)
LED1: R17.1, U1.2 (TA0CLK/ACLK/CA0/A0/P1.0)
LED1_A: D1.2 (A), R17.2
MISO: R13.2, U1.14 (TDI/TCLK/UCB0SOMI/UCB0SCL/TA0.1/CA6/A6/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), U3.2 (SO), U4.2 (DO/IO_{1})
MOSI: A1.8 (D1/DIN), U1.15 (TDO/TDI/UCB0SIMO/UCB0SDA/CAOUT/CA7/A7/P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), U3.5 (SI), U4.5 (DI/IO_{0})
OLED_CS: A1.15 (CS), R9.2, U1.8 (P2.0/TA1.0)
OLED_DC: A1.4 (DC), U1.9 (P2.1/TA1.1)
OLED_RST: A1.16 (RST), U1.10 (P2.2/TA1.1)
PWR_EN: A3.3 (EN), A4.1 (SHDN), SW9.2 (B)
RST: C2.1, J3.5, R12.2, U1.16 (~RST/NMI/SBWTDIO)
RXD: J3.3, U1.3 (UCA0RXD/UCA0SOMI/TA0.0/CA1/A1/P1.1)
SCK: A1.7 (D0/CLK), U1.7 (TMS/UCB0CLK/UCA0STE/TA0.0/CA5/A5/P1.5), U2.2 (CP), U3.6 (SCK), U4.6 (CLK)
SPK+: J2.1, R15.2
SPK_C: C9.2, R15.1
SRAM_CS: R10.2, U1.13 (P2.5/TA1.2), U3.1 (~CS)
SR_LOAD: U1.11 (P2.3/TA1.0), U2.1 (~PL)
SR_QH: R13.1, U2.9 (Q7)
TEST: J3.6, U1.17 (TEST/SBWTCK)
TXD: J3.4, U1.4 (UCA0TXD/UCA0SIMO/TA0.1/CA2/A2/P1.2)
VBAT: A2.5 (BAT), A3.1 (BAT), A4.2 (VIN), J1.1, R18.1
VBAT_SENSE: C14.1, R18.2, R19.1, U1.6 (TCK/SMCLK/UCB0STE/UCA0CLK/VREF+/VeREF+/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)
VOL_HI: C7.2, RV1.3
ZOBEL: C12.2, R16.1

Notes on the sheet:
MCU + PROGRAMMING
DISPLAY
MEMORY
INPUT
AUDIO
POWER
Generated by scripts/gen_schematic.py from pcb/handheld_design.py - do not hand-edit.
Pin map follows the firmware course: P2.3 SR_LOAD, P2.4 AUDIO_PWM (TA1.2), P2.5 SRAM_CS, P2.6 FLASH_CS.
J3 carries Spy-Bi-Wire (RST, TEST) and the UART to a LaunchPad eZ-FET; same signal order as its J101 block.
R13 isolates the 74HC165's always-driven QH from the shared MISO line. R9-R11 hold the chip selects high during reset.
SW9 grounds PWR_EN (PowerBoost EN + Pololu SHDN) to switch off; it carries no load current.

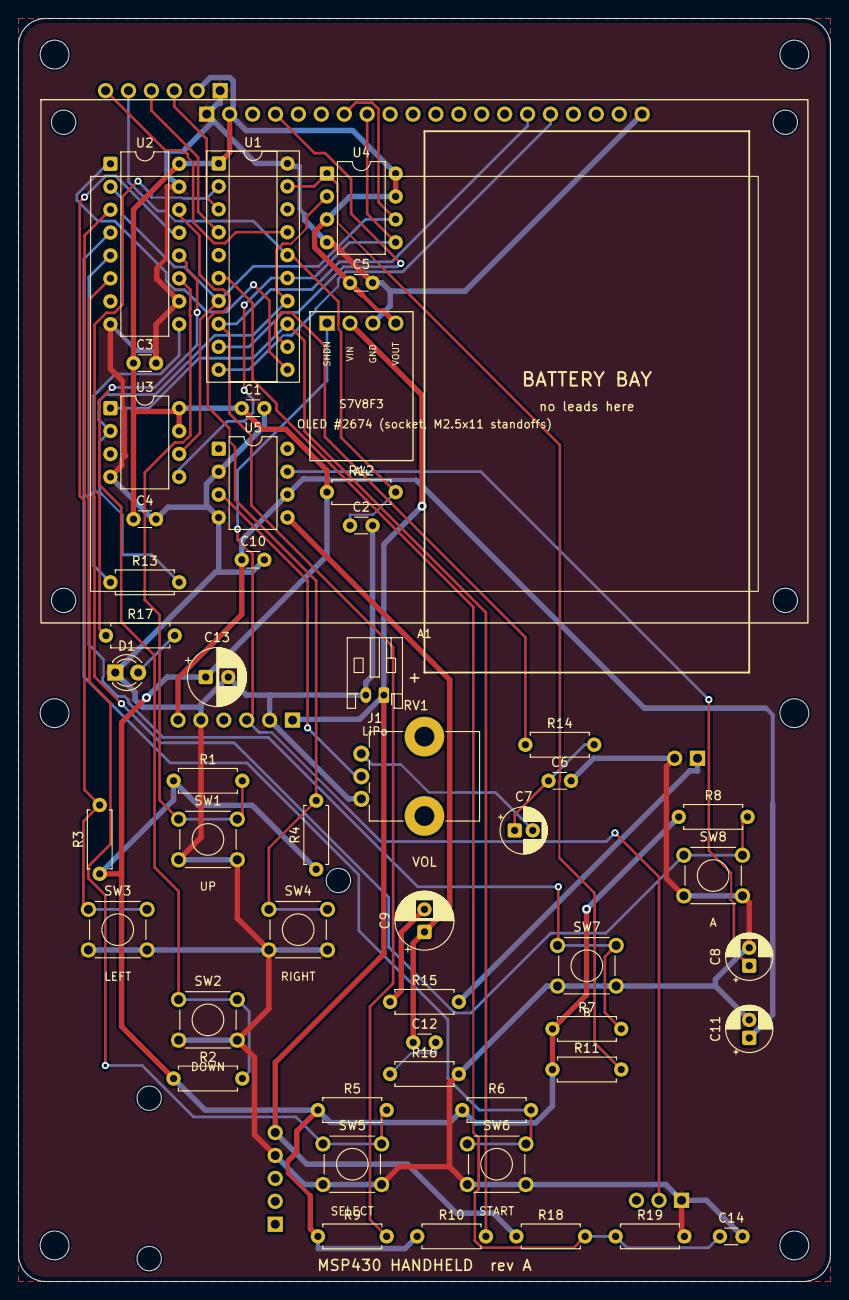
[picture p21: board msp430_handheld.kicad_pcb from above]

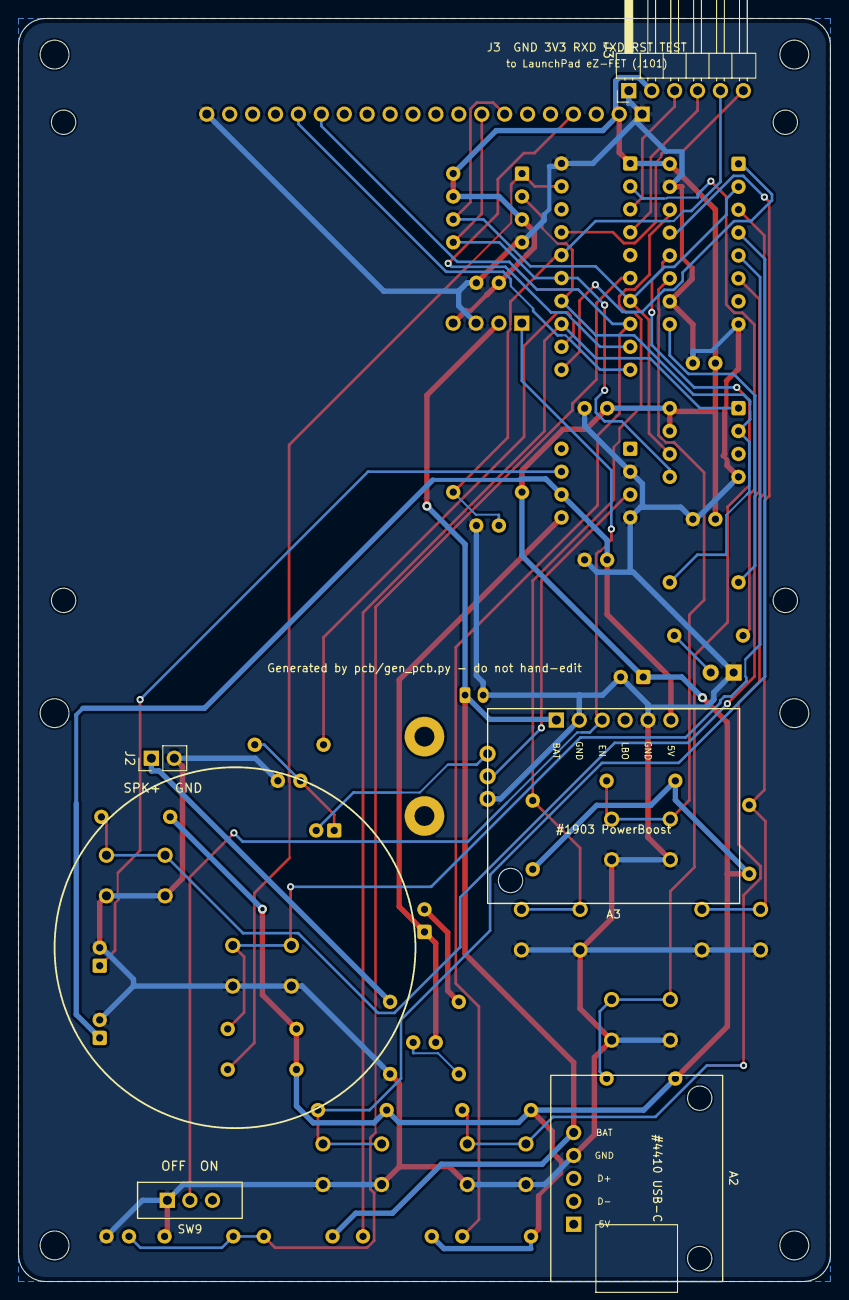
[picture p22: board msp430_handheld.kicad_pcb from below]

Board: 2 copper layers, 90.0 x 140.0 mm, 62 parts (5 on the bottom side), 39 nets.

Other parts of the board:
H1, H2, H3, H4, H5, H6: MountingHole_3.2mm_M3
