aradanmn/MSP430handheld-hardware/(commit log)

2026-03-02 Initial commit — Handheld MSP430 Game Boy clone
    Schematic rev 4.0 (gen_kicad7.py):
    - Grid-aligned positions fix: all cx/cy now multiples of 2.54 mm
    - Resolves 'nothing connected' bug (off-grid pin endpoints)
    - KiCad 9.0.7 native format (version 20250114)
    - All 12 format checks pass; kiutils validates cleanly
    Includes:
    - KiCad schematic (schematic/)
    - Breadboard layout SVG + guide (breadboard/)
    - Schematic generator scripts (scripts/)
    - Versioned engineering notes (notes/)
    - Session conversation log (logs/)
    [msp430_gameboy.kicad_sch]
2026-07-21 hardware: sync to rev 5.0 design, restructure as hardware-only repo
    Repo split: this repo becomes the hardware side of the handheld project; the
    firmware + 26-lesson course move to the companion software repo
    (aradanmn/msp430-handheld).
    - schematic/ update rev 4.0 -> rev 5.0 (OLED CS/DC/RST + SRAM + Flash) plus
    timestamped snapshots, from the software repo's newer design
    - breadboard/ refresh guide + SVG to the current layout
    - scripts/ refresh gen_kicad7.py to the current generator
    - bom-* add bill of materials (flat, structured, order CSV) at repo root
    - wiring/ add per-build-phase wiring guides (phase-1 .. phase-4)
    - README rewrite for rev 5.0 + new layou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
    [bom-order.csv, msp430_gameboy.kicad_sch, msp430_gameboy_20260327_185001.kicad_sch, msp430_gameboy_20260327_185623.kicad_sch]
2026-07-21 BOM Rev F: add power-regulation stage; fix incompatibilities
    Power review of the handheld BOM found it could not run from the LiPo:
    no voltage regulator existed, so raw cell (up to 4.2 V) would over-volt
    the MSP430G2553 (VCC abs-max 3.6 V), and the LM386N-1 audio amp (min
    supply 4 V) had no rail it could operate on.
    Added regulated-power stage:
    - 021 Adafruit PowerBoost 500 (#1903) — 5 V rail for the LM386
    - 022 Pololu S7V8F3 — 3.3 V buck-boost logic rail (full-cell safe)
    - 023 E-Switch EG1218 — master power switch
    Corrected descriptions:
    - 010 Adafruit #4410 relabeled "charge only, raw unregulated output"
    - LM386 note now specifies the 5 V rail (not 3.3 V)
    - 002 display relabeled mo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
    [bom-order.csv]
2026-09-19 Add component datasheets and pin-function reference
    Downloads official (or best-available) datasheet PDFs for every BOM
    component with a real pinout, indexed in datasheets/README.md with pin
    function tables for parts not already broken out in wiring/phase-*.md.
    Intentionally excludes the MSP430G2553 datasheet/family guide — the
    firmware repo's CLAUDE.md has the student look those up themselves.
    Flags two BOM entries that need verification: CSS-04008 speaker doesn't
    match a real CUI/Same Sky part number, and the Pololu S7V8F3's exact
    regulator IC isn't publicly documented by Pololu.
2026-11-09 Add rev A handheld carrier PCB and 3D-printed enclosure
    LaunchPad-as-MCU carrier board (90 x 140 mm, 2-layer, through-hole),
    generated from pcb/handheld_design.py, autorouted, DRC clean. Parametric
    OpenSCAD enclosure cut from the same numbers, with exported STLs.
    DESIGN.md records the plan, the pin map (follows the firmware course),
    findings in the existing design, and the dimensions to check before
    ordering. Nothing has been fabricated or printed yet.
2026-11-09 Put the MSP430G2553 on the board; add schematic rev 6.0
    The LaunchPad is the programmer, not the MCU board: replace the LaunchPad
    sockets with a socketed DIP-20 MSP430G2553, reset network, and a
    Spy-Bi-Wire + UART header (J3) on the top edge. Battery bay moves to the
    right of the OLED bay; the back cavity drops to 10.5 mm (32 mm overall).
    Add scripts/gen_schematic.py, which draws the schematic from the same
    table as the board, and scripts/check_netlist.py, which fails the build
    if the two differ on any pin.
